elkhayder/PFE-L3-2023-WeatherStation/README.md

##Node
- ID: Numeric or String
- Title: String
- Sensors: Array
	- Humidity
	- Temperature
	- Wind (Speed, Direction)
- Data: Array
	- Sensor
	- Value(s)
	- Timestamp
