elkhayder/PFE-L3-2023-WeatherStation/Arduino/Central/README.md

JSON object Format

```
{
    "node": String,
    "measure": String,
    "value": Numeric,
}
```

Rapport

-  Introduction

-  Architecture (TBD)

-  Noeuds

   -  Architecture
   -  Choice of parts and materials

-  Central

   -  Architecture
   -  Choice of parts and materials

-  Website

-  Protection of elements (TBD)

-  Conclusion
