elkhayder/PFE-L3-2023-WeatherStation/Report/glossaries.tex

\makeglossaries

\newacronym{ap}{AP}{Access Point}
\newacronym{wifi}{WiFi}{Wireless Fidelity}
\newacronym{http}{HTTP}{Hypertext Transfer Protocol}
\newacronym{db}{DB}{Database}
\newacronym{lora}{LoRa}{Long Range - Wireless transmission technique}
\newacronym{csv}{CSV}{Comma-seperated values}
