elkhayder/PFE-L3-2023-WeatherStation/Final Presentation.pptx

## WEATHER STATION : CENTRAL

FRIES Léo L3 ME
EL KHAYDER Zakaria L3 SE
OUFASKI Nouhaila L3 SE

2022 / 2023

## SUMMARY

- Specifications
- Quick Overview
- Deep Dive
  - Website
  - Central
  - Nodes
  - Housing
- Real life applications
- What did we learn ?

WEATHER STATION : CENTRAL FRIES EL KHAYDER OUFASKI

2

## SPECIFICATIONS

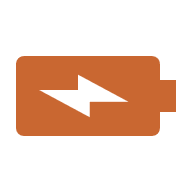
[picture p15: figure]

Data Visualisation

Low Power

Web interface and/or LCD Display

Can run on battery for long periods

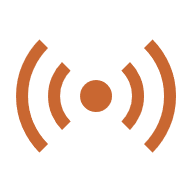
[picture p16: figure]
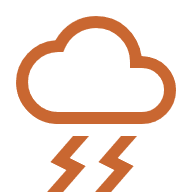
[picture p17: figure]

Long Range

Rigidity

Covering wide surrounding area

Handle the difficult weather conditions

WEATHER STATION : CENTRAL FRIES EL KHAYDER OUFASKI

3

## QUICK OVERVIEW

WEATHER STATION : CENTRAL FRIES EL KHAYDER OUFASKI

4

## DEEP DIVE

WEATHER STATION : CENTRAL FRIES EL KHAYDER OUFASKI

5

## WEBSITE

- Geolocation
- Weather
- Sunrise and sunset
- Weather forecast
- Nodes data visualisation

WEATHER STATION : CENTRAL FRIES EL KHAYDER OUFASKI

6

## DATA SERIALISATION

CSV (Comma-seperated values)

Bedroom,Temperature,25.3,1681168402
Bedroom,Temperature,9.02,1683082476
Bedroom,Temperature,1.40,1680957947
Bedroom,Temperature,4.38,1682126907

JSON (JavaScript Object Notation)

{
"node": "Bedroom",
"measure": "Temperature",
"value": 25.30,
"date": "2023-04-10T23:13:22.000Z“
}

Unix Timestamp

WEATHER STATION : CENTRAL FRIES EL KHAYDER OUFASKI

7

## APIs

{
"address": {
"city": "Strasbourg",
"county": "Bas-Rhin",
"state": "Grand Est",
},
}

{
"lat": 48.584652,
"lon": 7.762641
}

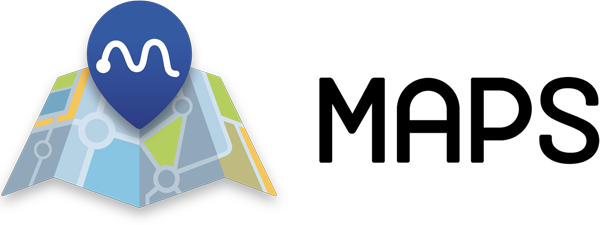
[picture p18: figure]
MAPS Logo

geocode.maps.co

HTTP

HTTP

WEATHER STATION : CENTRAL FRIES EL KHAYDER OUFASKI

8

6

## APIs

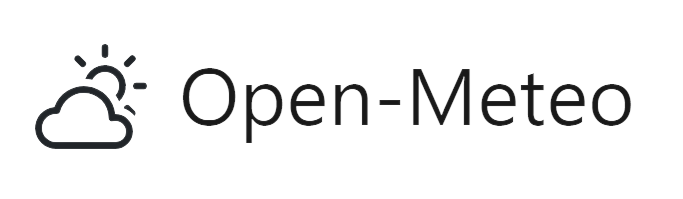
[picture p19: figure]

open-meteo.com

sunrise-sunset.org

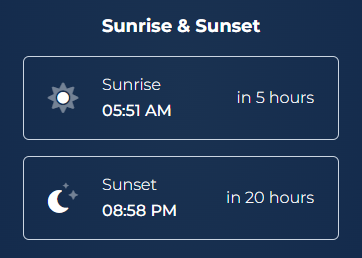
[picture p20: figure]
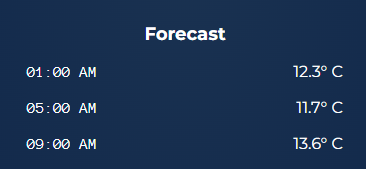
[picture p21: figure]

9

## DATA VISUALISATION

Input

const data = fetch('/api/db').then(x => x.text())

Line Feed (LF) = 0x0A

Output

"Bedroom,Temperature,25.3,1681168402\nBedroom,Temperature,9.02,1683082476\nBedroom,Temperature,1.40,1680957947\nBedroom,Temperature,4.38,1682126907"

WEATHER STATION : CENTRAL FRIES EL KHAYDER OUFASKI

10

## DATA VISUALISATION

Input

data
.map((x) => x.split("\n"))

[
"Bedroom,Temperature,25.3,1681168402",
"Bedroom,Temperature,9.02,1683082476",
"Bedroom,Temperature,1.40,1680957947",
"Bedroom,Temperature,4.38,1682126907",
]

WEATHER STATION : CENTRAL FRIES EL KHAYDER OUFASKI

Output

11

## DATA VISUALISATION

data
.map((x) => x.split("\n"))
.map((x) => {
const [node, measure, value, date] = x.split(",");
return { node, measure, value: +value, date: new Date(+date * 1000) };
});

[
{node: 'Bedroom', measure: 'Temperature', value: 25.3, date: …},
{node: 'Bedroom', measure: 'Temperature', value: 9.02, date: …},
{node: 'Bedroom', measure: 'Temperature', value: 1.40, date: …},
{node: 'Bedroom', measure: 'Temperature', value: 4.38, date: …}
]

WEATHER STATION : CENTRAL FRIES EL KHAYDER OUFASKI

Input

Output

12

## DATA VISUALISATION

Nodes

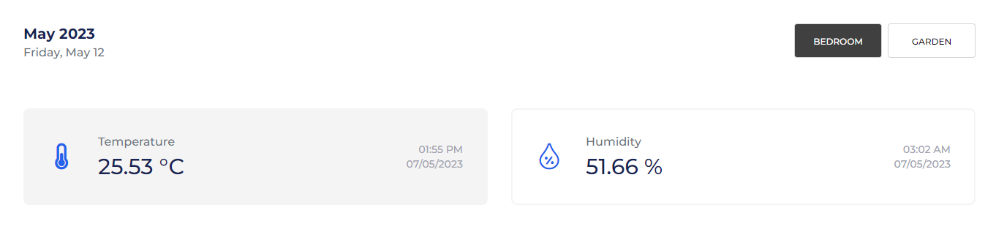
[picture p22: figure]

WEATHER STATION : CENTRAL FRIES EL KHAYDER OUFASKI

Latest measure

13

## DATA VISUALISATION

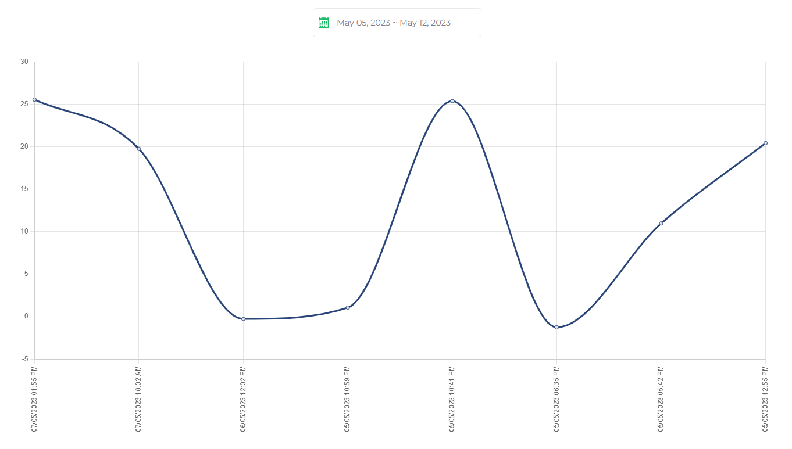
[picture p23: figure]
A picture containing text, diagram, plot, line

14

## CENTRAL

WEATHER STATION : CENTRAL FRIES EL KHAYDER OUFASKI

15

4

## ARCHITECTURE


WEATHER STATION : CENTRAL FRIES EL KHAYDER OUFASKI

16

## WIFI

WEATHER STATION : CENTRAL FRIES EL KHAYDER OUFASKI

17

## CLOCK

WEATHER STATION : CENTRAL FRIES EL KHAYDER OUFASKI

18

## CLOCK

now=unixtime+(t −t_0)/1000

WEATHER STATION : CENTRAL FRIES EL KHAYDER OUFASKI

19

## LoRa

WEATHER STATION : CENTRAL FRIES EL KHAYDER OUFASKI

20

## LoRa

{"node":"Bedroom","measure":"Temperature","value": 25.30}\n

Bedroom,Temperature,25.30

Bedroom,Temperature,25.30,1681168402

WEATHER STATION : CENTRAL FRIES EL KHAYDER OUFASKI

21

## SERVER

WEATHER STATION : CENTRAL FRIES EL KHAYDER OUFASKI

22

## LCD

WEATHER STATION : CENTRAL FRIES EL KHAYDER OUFASKI

23

## NODES

WEATHER STATION : CENTRAL FRIES EL KHAYDER OUFASKI

24

## SENSORS


DHT11

BMP388

WEATHER STATION : CENTRAL FRIES EL KHAYDER OUFASKI

25

## HOUSING

- Protect the components
- Design
- Integration

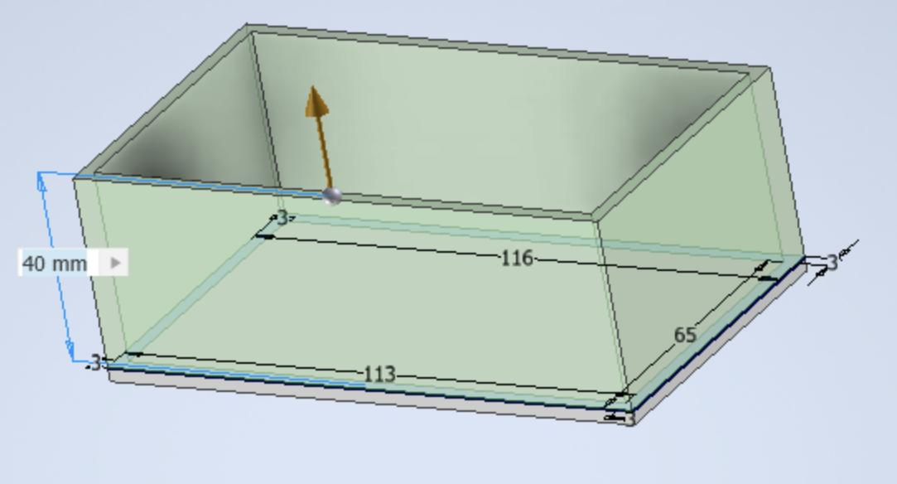
[picture p24: figure]

WEATHER STATION : CENTRAL FRIES EL KHAYDER OUFASKI

26

23

## NODES BOX

- Enough space for the components
- A place for the antenna
- Let the air flow

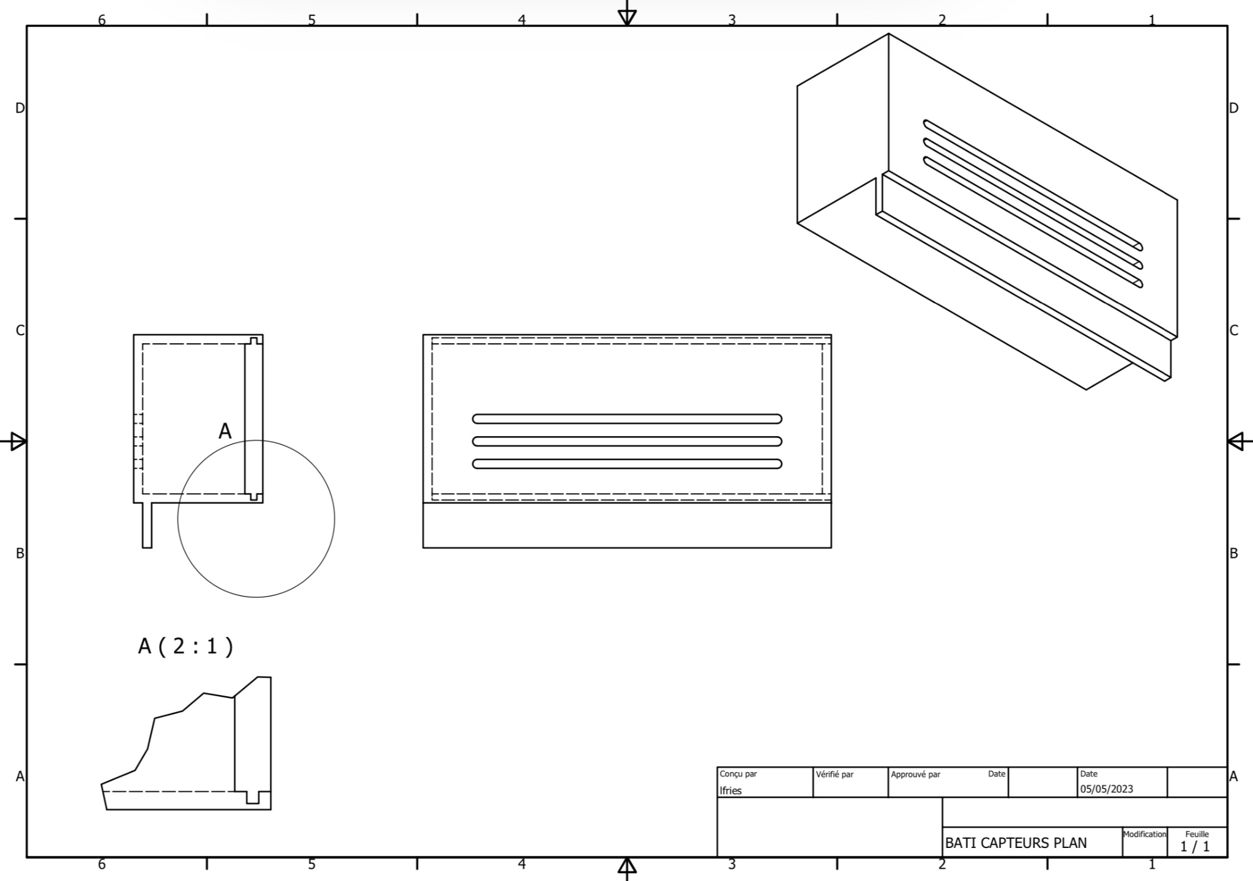
[picture p25: figure]

WEATHER STATION : CENTRAL FRIES EL KHAYDER OUFASKI

27

## CENTRAL BOX

- Space for the components and the screen
- Integrate the screen cleanly to the box
- Different possibilities of placement

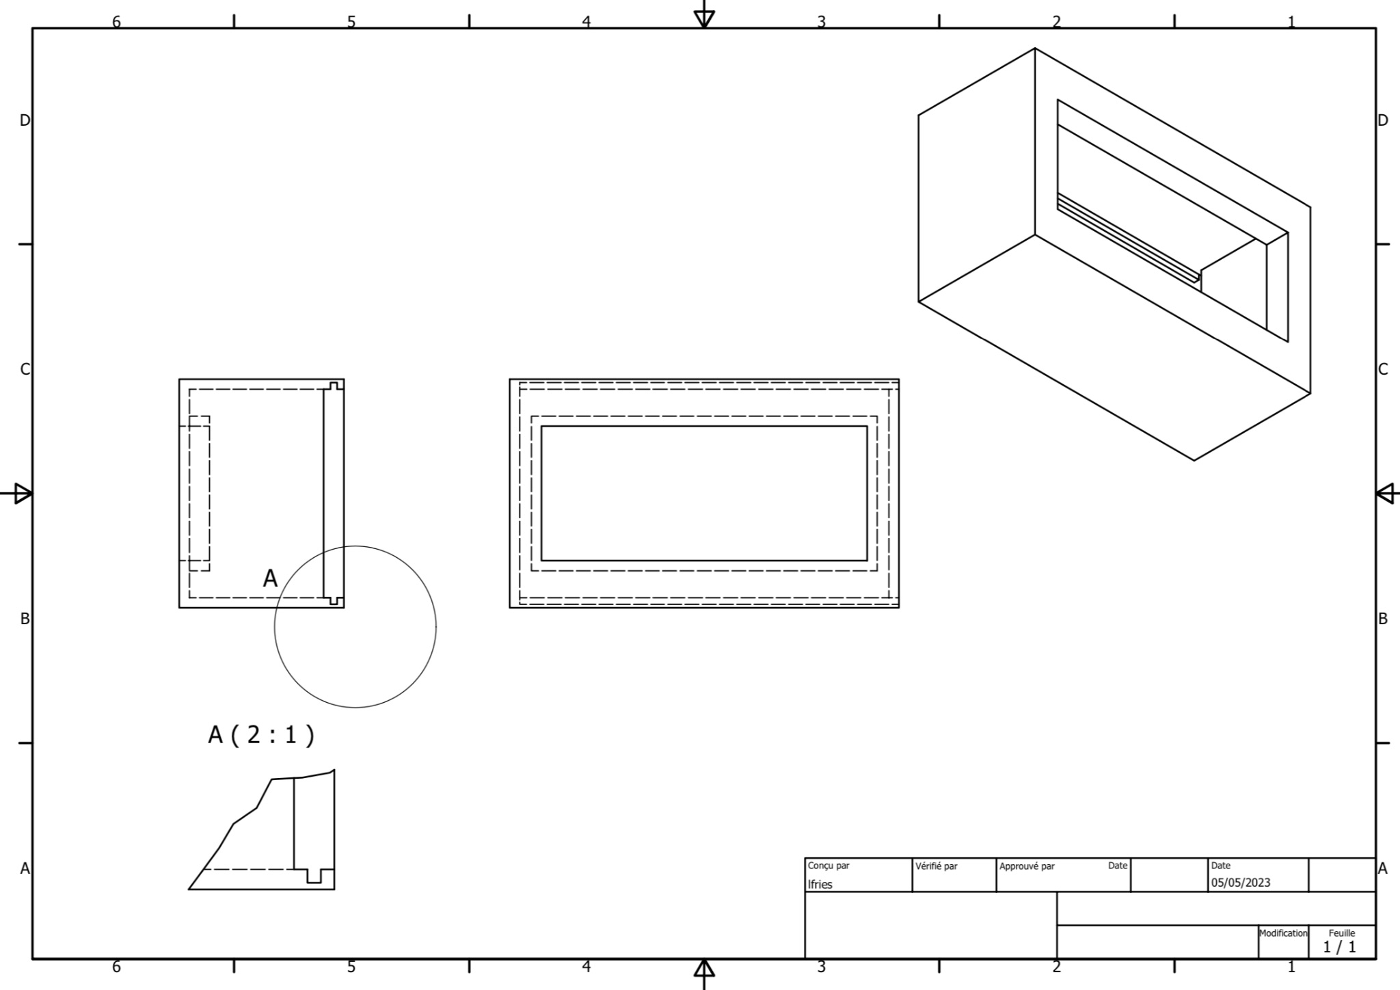
[picture p26: figure]

WEATHER STATION : CENTRAL FRIES EL KHAYDER OUFASKI

28

## LID OF BOXES

- 1st try —> Fail
  - Slides in the box
- 2nd try —> Succes
  - Fits in the box

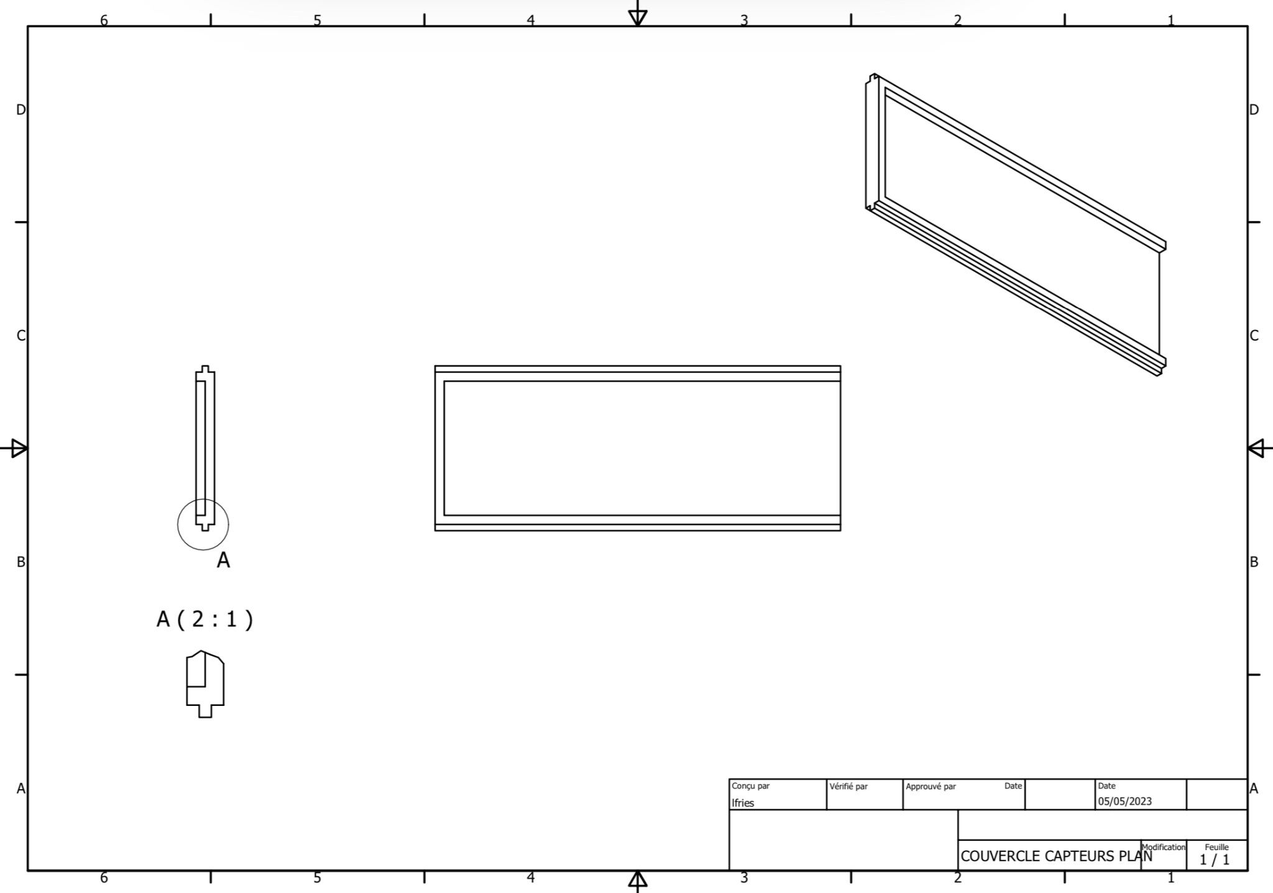
[picture p27: figure]

WEATHER STATION : CENTRAL FRIES EL KHAYDER OUFASKI

29

## REAL LIFE APPLICATIONS

- Domestic use
  - Gardening, Sport,
- Professional use
  - Factories, Outside jobs

WEATHER STATION : CENTRAL FRIES EL KHAYDER OUFASKI

30

## WHAT DID WE LEARN ?

- New technologies
- Team work
- Experience

WEATHER STATION : CENTRAL FRIES EL KHAYDER OUFASKI

31

## Thank you for your attention

WEATHER STATION : CENTRAL FRIES EL KHAYDER OUFASKI

32
